Intechgent/esp32-self-balancing-robot/docs/BUILD_LOG.md

# Build Log

A running, honest record of what I built, what broke, and how I fixed it.
The point of this log is to document my *understanding* and problem-solving,
not just the final result.

---

## 2026-07-02 - Reading a stable tilt angle (in simulation)

**What I did:**
Started in the Wokwi simulator (before hardware arrived) to build the "sense"
stage of the balancing bot. Wired a virtual MPU6050 to the ESP32 over I2C
(SDA→GPIO21, SCL→GPIO22) and read a tilt angle from the accelerometer using
`atan2(y, z)`.

**What I observed / what went wrong:**
The angle only responded when I changed the sensor's *acceleration*, not when
I changed its *rotation*. At first this seemed wrong.

**Why (what I learned):**
An accelerometer doesn't measure rotation - it measures acceleration, and at
rest the only acceleration present is gravity. So the accelerometer angle is
really "which way is down," which is why tilting (not spinning) moved it. The
accelerometer angle is correct on average but noisy, and it can't tell gravity
apart from the robot's own motion - a problem, because a balancing bot
accelerates constantly.

**The fix (what I understood I needed):**
Add the gyroscope (which measures rotation *rate*) and fuse both sensors with a
**complementary filter**:
`angle = α·(angle + gyro_rate·dt) + (1−α)·accel_angle`, with α = 0.98.
The gyro handles fast changes; the accelerometer slowly corrects gyro drift.
I implement and verify this in the next entry (2026-07-04).

**Takeaway:**
Understood *why* sensor fusion is necessary rather than just copying it - each
sensor covers the other's weakness. This is the foundation the whole control
loop sits on.

**Verified findings (accelerometer-only baseline):**
- Resting angle reads 0°; tilting changes it, rotation alone does not (as expected)
- X-axis acceleration has no effect - confirms only Y and Z are in the atan2 formula
- y=1g → 90°, z=1g → 0°, y=z=1g → 45°: atan2 computes the *direction* of gravity
  between the two axes, not just magnitudes

---

## 2026-07-04 - Verifying the complementary filter (step 2)

Re-ran the fused-angle code deliberately, testing each axis one at a time.

**Verified findings**
- X-axis *rotation* now moves the Fused angle but not Accel - the gyro is
  contributing, and Accel's blindness to rotation is confirmed
- Y/Z rotation affect nothing - we only read gyro.x, since a balancing bot
  tips around one axis only
- Accel jumps to ±90° when gravity is fully on y, and 180° when z is
  negative (sensor upside down)
- Fused follows motion quickly but settles toward Accel's value - the 2%
  accelerometer correction visibly anchoring the gyro

---

## 2026-07-04 - PID controller (step 3)

**What I did:**
Added a PID controller that converts the fused tilt angle into a motor
command: `output = Kp·error + Ki·errorSum + Kd·dError`, clamped to the motor
range (-255 to 255). Started with Kp=25, Ki=0, Kd=0.8.

**Why I set Ki = 0 to start:**
Deliberately disabled I so I can tune P and D first - the textbook PID tuning
order (get P and D stable, add I last to remove residual lean). Turning I on
too early makes it fight P and D before they're dialed in.

**What P, I, D each do:**
- P pushes harder the more I'm tilted, but alone it overshoots and wobbles.
- D brakes based on how fast the angle is changing, damping the wobble.
- I accumulates small persistent leans and corrects steady offset.

**Verified findings (via Wokwi sliders):**
- Positive Y acceleration → negative output, and vice versa: the controller
  pushes *against* the tilt, as intended.
- Output saturates to ±255 quickly with few in-between values - expected in
  sim, because Kp=25 is high and the sliders jump the angle in coarse steps,
  so even small errors exceed the clamp. Confirms the clamp works.
- All inputs zero → angle 0.0, output ~0: balanced state produces no command.

**What I learned:**
The clamp prevents meaningless out-of-range motor values, and slider-driven
testing proves the control *logic* even though the sim has no real physics to
"fall." Smooth in-between outputs will appear on real hardware with fine tilts
and proper tuning.

**Known issue (next):**
`errorSum` is currently unclamped, so once I enable Ki it can wind up during a
sustained lean and overshoot on recovery. I'll add anti-windup (clamp the
integral, or only integrate near upright) before turning Ki on.

---

## 2026-07-18 - First readings on real hardware (and an MPU6500 surprise)

**What I did:**
Moved off the simulator onto real hardware. Set up PlatformIO for the ESP32
DevKit V1, wired the IMU module over I2C (SDA→GPIO21, SCL→GPIO22), and got live
accelerometer and gyroscope readings from the physical sensor.

**What went wrong:**
Two unrelated problems that masked each other:
1. No COM port appeared, so every upload failed with *"Please specify
   `upload_port`"*. The board was fine - Windows had no driver bound to its
   CP2102 USB-to-UART chip (Device Manager showed it with an error and no class).
2. Once uploads worked, an I2C scan clearly found a device at `0x68`, but
   `mpu.begin()` from the Adafruit MPU6050 library still reported
   *"MPU6050 not found"*.

**How I fixed it:**
1. Installed the Silicon Labs CP210x VCP driver manually - Windows Update
   didn't have it. `COM5` appeared and uploads worked immediately.
2. For the sensor, instead of rewiring again I read the **WHO_AM_I** register
   (`0x75`) directly. It returned **`0x70`**, not `0x68` - so this module is an
   **MPU6500**, not a genuine MPU6050. The Adafruit library validates WHO_AM_I
   and rejects anything that isn't `0x68`, which is why a perfectly working
   sensor was reported as missing. I dropped the library and read the registers
   directly; the MPU6500 is register-compatible for accel/gyro.

**What I learned:**
- Test one layer at a time. The I2C scanner proved the wiring was good, so
  "not found" *had* to be software. Without that check I'd have kept rewiring a
  circuit that was already correct - which I did twice before thinking to ask
  the chip what it was.
- "Responds at address `0x68`" and "is the chip the library expects" are two
  different claims. One register read settled it.
- A serial port can only be held by one program: the monitor must be closed
  before uploading, or the upload silently doesn't happen and you end up
  testing stale firmware and drawing wrong conclusions.

**Units gotcha (and why it matters):**
The Adafruit library returned gyro rates in **rad/s**, so the Wokwi code
converted with `* 180/PI`. Reading the registers directly, I divide the raw
value by 131 LSB/(deg/s), so the result is **already in deg/s**. If I carried
the old conversion over as well, I'd multiply by 180/π (≈57.3) a second time
and the gyro term would be ~57× too large - the complementary filter would
swing wildly on the slightest rotation and the fused angle would be useless.
Same physical quantity, different units, silent failure: worth pinning down
now rather than debugging as "mystery drift" later.

**Verified findings (first real readings):**
- Resting roughly flat: `z ≈ 9.78`, `y ≈ 0.20`, `x ≈ -1.40` (the steady x offset
  is just the breadboard sitting ~8° off level).
- Vector magnitude √(x²+y²+z²) ≈ **9.88 m/s² ≈ 1g** - confirms the raw-to-units
  scaling (16384 LSB/g) is correct. If the conversion were wrong this wouldn't
  land on gravity.
- **Gyro reads ~+0.9 °/s while completely still, not 0** - this is gyro bias, a
  normal MEMS characteristic. Integrated on its own it would drift the angle by
  roughly 54° per minute, which is precisely what the complementary filter's
  accelerometer correction is there to cancel. Seeing the drift I'd only read
  about made the reason for sensor fusion concrete.

**Next:** port the complementary filter to hardware, then verify the gyro sign
agrees with the accelerometer angle on this physical mounting. Also worth
measuring the resting gyro bias and subtracting it, so the filter starts from a
cleaner signal.

---

## 2026-07-21 - Complementary filter on real hardware (sense layer validated)

**What I did:**
Ported the complementary filter from the Wokwi sim onto the real MPU6500. Fused
the accelerometer tilt angle (`atan2(y, z)`) with the integrated gyro rate into
one stable angle, reading the registers directly. Added a startup step that
averages 500 samples while the board is held still to measure the resting gyro
bias, then subtracts it every loop.

**Two conversions I had to keep straight:**
`atan2` returns radians, so the accel angle still needs `* 180/PI`. The gyro,
read as raw/131, is already deg/s and must NOT get that conversion - applying
both would make the gyro term ~57x too large. Same idea, adjacent lines, easy
to conflate - so I commented it explicitly.

**Verified findings (real hardware, tilted by hand):**
- At rest: fused holds steady at ~4.2° while the raw accel angle jitters ±0.5°,
  with no creep over a minute - the bias subtraction is working.
- Tilt and hold ~17°: accel and fused both move there and agree when steady;
  fused is visibly smoother through the motion.
- Sign check: during a rotation the fused angle *leads* the accel angle in the
  same direction (gyro reacts instantly, the noisy accel catches up). Because it
  tracks *with* accel rather than against it, the gyro sign is correct on this
  mounting - no flip needed. I'd left a one-line `GYRO_SIGN` switch in case it
  wasn't.

**What I learned:**
The "gyro leads, accelerometer catches up" behaviour is the whole point of the
filter made visible: the gyro gives the fast smooth response, the accelerometer
slowly anchors it against drift. Seeing it on real, noisy hardware rather than
the clean sim is what made it click.

**Next:** motor driver bring-up (TB6612FNG), tested in isolation before wiring
any control to it.

---

## 2026-07-21 - Motor driver bring-up (TB6612), and a battery-holder red herring

**What I did:**
Wired one motor to the TB6612FNG (channel A: `PWMA` + `AIN1`/`AIN2` → `AO1`/`AO2`),
powered the driver from a single charged 18650 (~3.7 V - the pack is still
mislabelled), and drove the motor forward / stop / reverse from code using the ESP32
`ledc` PWM API. A bring-up test only - no IMU, no control - to prove the
driver + motor + code path before wiring anything to it.

**What went wrong (the long part):**
The motor wouldn't spin, and I spent a long time assuming the driver was at fault.
I isolated it one layer at a time instead:
- ESP32 + code fine (serial printed forward/stop/reverse)
- Motor fine (spun on a single bare cell)
- Common ground, STBY, VCC vs VM, channel A vs B - all checked; even swapped the
  motor to channel B and it was still dead.
The actual cause was the battery pack's polarity markings: plus was labelled
minus and minus was labelled plus, so the two cells in series fought each other
instead of adding up, and `VM` saw no usable power. Single cells still spun the
motor fine on their own because polarity didn't matter when only one cell was
in the circuit. The fix was reseating the cells against their actual polarity,
not the pack's printed labels.

**What I learned:**
- Don't anchor on the newest / most complex part. I suspected the driver for ages
  when it turned out to be a mislabelled ~$2 battery pack instead.
- Test the *assembled* power source, not just individual cells. Checking the
  holder's real output was the one step I skipped early and should have done first.
- Stranded holder leads don't seat reliably in dupont/breadboard holes; they need
  tinning or a soldered pin.

**Result:** motor runs forward and reverse on command - the "act" layer works.
(Tested on a single cell at ~3.7 V; running it off the full 7.4 V pack is pending
the pack's polarity being fixed.)

**Next:** sort out reliable pack power (reseat the cells correctly), then connect the
PID output to the motor command.

---

## 2026-08-24 - Control loop verified on hardware; second motor added

**What I did:**
Brought the integrated control loop (fused angle → PID → motor command) to life
on real hardware, verified its logic, and extended it to drive both motors.

**Getting the IMU back (multimeter debugging):**
After a break, the IMU wouldn't respond - the I2C bus hung (`requestFrom Error
-1`, then the scanner froze on "Scanning..."). I chased it with the multimeter:
- The 3.3 V rail read a healthy **3.31 V**, but the IMU's own `VCC` pin read
  only **1.5 V**.
- Idle `SDA`/`SCL` sat at ~1.95 V instead of ~3.3 V - the pull-ups were
  referenced to that starved VCC.
- Root cause: **dead breadboard holes** on the IMU's power connection, dropping
  3.31 V → 1.5 V. Below the MPU's ~2.4 V minimum, so it couldn't run and jammed
  the bus. Moving the IMU power to fresh holes fixed it - the scanner instantly
  found `0x68`.

**Verified findings (control loop, real hardware):**
- Tilt past 45° → `cmd 0 STOP`: the fall-cutoff fires (treated as toppled).
- Tilt ~34° / ~17° → `cmd -255`: big lean = full-power correction, hitting the clamp.
- Small lean (~4°) → small `cmd`, dropping below the pure-P value as it returns
  upright - the **D-term damping** made visible.
This confirms the whole sense → think chain is correct on hardware.

**What I learned:**
- A frozen I2C scanner means the bus is stuck low - measure the line voltages.
  Idle I2C should sit near VCC (~3.3 V); much lower = starved supply or a short.
- Breadboard holes wear out. "Correct" wiring can still fail on a dead hole, and
  the multimeter is the only way to actually see it.

**Second motor:** added channel B (`BIN1`/`BIN2`/`PWMB` → `BO1`/`BO2`), driven
from the same command, with a `MOTOR_B_INVERT` flag for the mirrored mounting.
**Not yet tested** - two-motor drive and balancing wait for assembly, battery
power, and tuning.

**Next:** mount on the chassis, power both motors from the pack, confirm they
drive the right way (flip `MOTOR_B_INVERT` if it spins in place), then tune
`Kp`/`Kd`.

**Update (same day) - both motors driving + bot assembled:**
Powered both motors from the 7.4 V pack and got them driving from the control
loop on hardware. The "not yet tested" above came down to loose motor-to-`AO`
joints: the multimeter showed the driver output was fine (~7.5 V at `AO1`) but no
voltage reached the motor, so the connection was open. With the motor wires
seated properly, both motors now respond to tilt. Assembled the whole thing onto
the chassis.

**Still to do:** solder one motor wire that won't stay seated, then tune. At the
current gains the wheels only move on a fair-sized tilt - small commands fall
below the geared motors' start threshold (stiction), so the tuning fix is a
higher `Kp` plus a minimum-PWM floor so small corrections still turn the wheels.
Balancing itself is untested and waits on tuning.

---

## 2026-08-28 - Orientation fix, a channel-B pin bug, and first tuning attempts

**What I did:**
Picked the project back up after a break to debug the assembled bot: fixed the
IMU's angle for its vertical mounting, found and fixed a motor wiring/pin bug,
and made the first live `Kp` tuning attempts.

**Bug 1 - upright read ~-176°, not 0°:**
The angle formula (`atan2(ay, az)`) was written when the IMU sat flat in
simulation. Mounted vertically on the standing bot, forward/back tilt actually
shows up on the **X-Z accelerometer plane and the Y gyro axis**. I confirmed
this with a raw-axis diagnostic (holding the bot upright, tipped forward, tipped
back, and logging `ax/ay/az/gx/gy/gz` at each). Fixed the angle to
`atan2(ax, -az)` with a small offset so upright reads ~0 instead of sitting on
the atan2 ±180° wraparound (which caused wild jumps between readings).

**Bug 2 - one motor only ever spun one physical direction:**
Direction control on channel B wasn't toggling correctly - the wheel didn't
reverse between FWD and REV no matter the command. Traced it to a pin mismatch:
the code's `PWMB`/`BIN1`/`BIN2` didn't match the GPIOs actually wired on the
board (mixed up during rewiring). Fixed by matching the code to the real
wiring (`PWMB=14, BIN1=32, BIN2=13`) and setting `MOTOR_B_INVERT = true` since
the two motors are mounted mirrored. Verified with a direct motor test
(bypassing the IMU/PID entirely) that each motor reverses correctly and both
now drive the same way.

**Also fixed:** `BALANCE_OFFSET` needed recalibrating (7.0 -> 1.5) after all the
rewiring shifted the IMU slightly and upright drifted to ~-5.5°.

**First tuning observations:**
With `Kp=25`, small leans produced too small a command to react in time (a 3°
lean only gave `cmd ≈ 75/220`), so the bot kept falling until the lean was
already large, then the command spiked and overcorrected - it looked like
"slow response, then too fast." Raised `Kp` to 60 so smaller leans get a
stronger, earlier response. Also raised `MAX_CMD` from 180 to 220 - 180
couldn't arrest a ~20° lean before it kept climbing.

**What I learned:**
- A control loop can look "sluggish" for reasons that have nothing to do with
  timing: here it was a gain too small for small errors, not a slow loop.
  Reading the actual `cmd` numbers at different lean angles (not just watching
  the bot) is what revealed it.
- Intermittent I2C errors (`requestFrom Error -1/263`) reappeared during this
  session from wire handling - worth remembering that any "weird" control
  behaviour should first be checked against a clean, error-free serial log,
  or you end up tuning against corrupted data.
- Debugging a two-motor system needs isolation exactly like the sensor debugging
  did: a direct motor test with no IMU/PID in the loop was what proved the pin
  bug was electrical, not a control/tuning issue.

**Status at time of writing:** the full sense -> think -> act loop runs
correctly on hardware - orientation, both motors' direction, and the control
sign have all been verified. Sustained self-balancing has not been confirmed
yet at this point; `Kp=60, Ki=0, Kd=0.8` is a first tuning pass. (It did
balance, tethered to USB, in testing after this entry - see the closing
section below.)

---

## Project archived

After the 2026-08-28 tuning pass, `Kp=60, Ki=0, Kd=0.8` turned out to be enough:
the bot balanced on its own while tethered to USB for power. I didn't record
it on video and didn't get to test it running off the battery pack alone
before I ran out of project time, so that's where I'm closing this build.

I'm choosing to end the log here rather than stretch it out: the part I set
out to understand - building and debugging a real closed-loop control system
across sensing, filtering, control, and actuation, on hardware that fought
back at every layer - is done, verified, and it balances. What's left is
cutting the USB tether and proving it holds up on battery power alone, which
needed time I didn't have left. See the README's
[Results](../README.md#results) and
[What I'd do next](../README.md#what-id-do-next-if-i-picked-this-back-up)
sections for where this would continue.
