Intechgent/esp32-self-balancing-robot/(commit log)

2026-07-04 Add complementary filter: fuse gyro and accelerometer for stable tilt
2026-07-08 Add PID control law to sim: compute motor command from fused angle (untuned)
2026-07-21 Add complementary filter on hardware; validate fused tilt angle
    - Port the sim filter to the MPU6500 via direct register reads (gyro already
    deg/s, so no rad/s conversion)
    - Measure and subtract resting gyro bias at boot
    - Verified on hardware: stable at rest, tracks tilt, correct gyro sign (no flip)
    [main.cpp]
2026-07-21 Add TB6612 single-motor bring-up test (validated on hardware)
    - Drive one motor forward/stop/reverse via channel A using the ESP32 ledc PWM API
    - Bring-up only: no IMU or PID yet
    - Verified on a single 18650 (~3.7V); full 7.4V pack pending a working holder
    [main.cpp]
2026-07-28 Integrate control loop: fused angle -> PID -> motor command
    - Combine complementary filter (sense), PID (think), and TB6612 drive (act)
    into one loop; signed motor command, anti-windup clamp, 45-degree fall-stop
    - Prints the command over serial for bench verification without motor power
    - Compiles clean; gains untuned and NOT yet bench-verified (verification +
    actuation pending; battery holder replacement on the way)
    [main.cpp]
2026-08-25 Drive both motors; verify control loop on hardware
    - Verified on hardware (single motor + serial): fused angle -> PID -> command
    is correct - scales with tilt, direction flips, 45-degree fall-cutoff fires,
    D-term damps on the way back to upright
    - Add second motor (channel B) driven from the same command, with a
    MOTOR_B_INVERT flag for the mirrored mounting - not yet tested under power
    - Build log: document the IMU I2C debug (dead breadboard holes starving VCC)
    [main.cpp]
2026-08-29 Build log: both motors driving from the loop on hardware; bot assembled
    - The two-motor drive added earlier now works - the holdup was loose motor-to-AO
    joints (multimeter: driver output fine at ~7.5V, but no voltage reached the
    motor). Reseated, both motors now respond to tilt.
    - Assembled onto the chassis.
    - Remaining: solder one motor wire, then tune Kp/Kd (+ a minimum-PWM floor for
    the geared motors' stiction). Balancing itself still untested.
2026-09-01 Fix IMU orientation for the vertical mounting; upright = 0
    - The IMU is mounted vertically, so forward/back tilt lives on the X-Z accel
    plane and the Y gyro axis - not the Y-Z / X the flat-board code assumed. Angle
    is now atan2(ax, -az) with a small offset (BALANCE_OFFSET) so upright reads ~0.
    - Was reading ~-176 (sitting on the atan2 wraparound -> wild jumps) and only
    reacting to side-to-side tilt. Verified on hardware: ~0 upright, moves sensibly
    on forward/back.
    - Cap MAX_CMD to 180 during testing so a stalled/oscillating motor can't overheat.
    [main.cpp]
2026-09-03 Fix channel B pin mapping and motor mirroring; both wheels verified
    - Channel B pins didn't match the actual wiring (PWMB/BIN2 were on the wrong
    GPIOs), so one motor's direction control never toggled cleanly - it only
    spun one physical direction regardless of command. Corrected to the real
    wiring: PWMB=14, BIN1=32, BIN2=13.
    - Set MOTOR_B_INVERT = true: the two motors are mounted mirrored, so the same
    command spun them opposite ways.
    - Verified on hardware, wheels free in the air: both wheels now reverse
    correctly and drive together, and tipping forward drives the wheels under
    the fall (the correct catching direction).
    [main.cpp]
2026-09-03 Recalibrate balance offset, raise MAX_CMD and Kp for hardware tuning
    - BALANCE_OFFSET 7.0 -> 1.5: rewiring shifted the IMU slightly, upright was
    reading -5.5 deg instead of ~0
    - MAX_CMD 180 -> 220: 180 couldn't arrest a ~20 deg lean in time; wheels are
    free-spinning (not stalled) at this level
    - Kp 25 -> 60: small leans produced too small a command (25*3deg = 75/220),
    so it kept falling until the lean was large, then overcorrected hard.
    Higher Kp reacts sooner to small leans.
    Balancing is not yet stable - this is in-progress tuning, documented honestly
    in the build log.
    [main.cpp]
2026-09-03 Document orientation fix, motor pin bug, and tuning status honestly
    - Build log: full account of the vertical-mounting angle fix, the channel-B
    pin mismatch that made one motor spin only one direction, and the first
    live Kp tuning pass (25 -> 60)
    - README: fill in sensor fusion, PID, wiring (real GPIOs), architecture, and
    an honest Results section - control loop verified end-to-end on hardware,
    sustained balancing not yet reached, tuning in progress
2026-09-14 Add build photos and demo clip to README
    - media/: chassis-front, chassis-empty, esp32-closeup, wiring-closeup,
    assembly-overview (renamed from device-generated filenames), demo.mp4
    - README: hero photo + demo clip up top (clearly captioned as a manual tilt
    reaction, not a balancing run), hardware/wiring photos in their sections
2026-09-15 Rewrite README in a more natural voice, fix stale build log anchor
    - README reworded throughout to read less like generated boilerplate:
    shorter sentences, fewer bolded keywords, plainer explanations of the
    filter, PID tuning, and the orientation bug
    - Removed all em dashes from README and build log
    - Fixed a build log link pointing at an old README section heading
2026-09-15 Correct battery fault claim: don't assert a mechanism I'm not sure of
    The build log and README both stated the battery holder had a bad internal
    contact. On review, that specific cause isn't actually certain anymore, so
    reworded to describe only what's known for sure: individual cells worked,
    the assembled pack didn't deliver power to VM, and swapping the holder and
    reseating fixed it. Same practical story, without overclaiming a root cause.
2026-10-08 Fix LICENSE holder, clarify power/next-steps, pin platform version
2026-10-08 Update README and build log: confirm balancing on USB tether, correct battery-fault cause
2026-10-09 Fix leftover battery-holder wording in build log to match polarity cause
